David-Estevez/hebi/README.md

hebi
====

Electronics board for modular robots
