David-Estevez/hebi/KiCAD/bom.ods

Sheet: Old
ref | value | component info | manufacturer ref | price | footprint
C1 | 100nF | Ceramic, 0603 | VJ0603Y104KXJCW1BC |  | 0603
C2 | 24pF | Ceramic, 0603 | - |  | 0603
C3 | 24pF | Ceramic, 0603 | - |  | 0603
C4 | 10nF | Ceramic, 0603 | - |  | 0603
C5 | 4.7uF | Ceramic, LSR, 0805 | VJ0805V475ZXQTW1BC |  | 0805
C6 | 1uF | Tantalum, 1206 | - |  | 1206
C7 | 1uF | Tantalum, 1206 | - |  | 1206
C8 | 100nF | Ceramic, 0603 | VJ0603Y104KXJCW1BC |  | 0603
C9 | 100nF | Ceramic, 0603 | VJ0603Y104KXJCW1BC |  | 0603
C10 | 4.7uF X7R 0805 | X7R cap, 0805 | C2012X7R1A475M125AC |  | 0805
C11 | 220nF | Ceramic, LSR, 0603 | CC0603KRX7R7BB224 |  | 0603
C12 | 1uF X7R 0805 | X7R cap, 0805 | VJ0805Y105KXQTW1BC |  | 0805
C13 | 100nF | Ceramic, 0603 | VJ0603Y104KXJCW1BC |  | 0603
C14 | 100nF | Ceramic, 0603 | VJ0603Y104KXJCW1BC |  | 0603
C15 | 2.2uF | Tantalum ESR < 2, 1411 | T491B225K016AT |  | 1411
C16 | 100nF | Ceramic, 0603 | VJ0603Y104KXJCW1BC |  | 0603
C17 | 100nF | Ceramic, 0603 | VJ0603Y104KXJCW1BC |  | 0603
C18 | 2.2uF | Tantalum ESR < 2, 1411 | T491B225K016AT |  | 1411
C19 | 100nF | Ceramic, 0603 | VJ0603Y104KXJCW1BC |  | 0603
C20 | 100nF | Ceramic, 0603 | VJ0603Y104KXJCW1BC |  | 0603
C21 | 100nF | Ceramic, 0603 | VJ0603Y104KXJCW1BC |  | 0603
C22 | 22uF | Electrolytic, 5x5.3x5.3 | AVE226M10C12T-F |  | Custom (done)
C23 | 100nF | Ceramic, 0603 | VJ0603Y104KXJCW1BC |  | 0603
C24 | 100nF | Ceramic, 0603 | VJ0603Y104KXJCW1BC |  | 0603
C25 | 1uF | Ceramic, 0603 | VJ0603V105MXQPW1BC |  | 0603
C26 | 1uF | Ceramic, 0603 | VJ0603V105MXQPW1BC |  | 0603
CR1 | CG0603MLC-05LE | ESD Suppressor | 652-CG0603MLC-05LE | 0,32 € | 0603
CR2 | CG0603MLC-05LE | ESD Suppressor | 652-CG0603MLC-05LE | 0,32 € | 0603
D1 | GREEN | Green LED, 0603 | - |  | Mod footprint
D2 | ORANGE | Orange LED, 0603 | - |  | Mod footprint
D3 | RED | Red LED, 0603 | - |  | Mod footprint
D4 | BLUE | Blue LED, 0603 | - |  | Mod footprint
D5 | D_SCHOTTKY | 1A, 0.52V, DO-214AC (SMA) | B120-E3/5AT | 0,08 € | Custom (done)
D6 | D_SCHOTTKY | 1A, 0.52V, DO-214AC (SMA) | B120-E3/5AT | 0,08 € | Custom (done)
F1 | MF-MSMF050-2 | Resettable fuse | MF-MSMF050-2 | 0,17 € | Custom (done)
JP1 | JP_5 | SWD debug connector | B5B-ZR-SM4-TF |  | Custom (done)
JP2 | JUMPER-2 | Solder Jumper | Solder Jumper | 0 | 0402
JP3 | JUMPER-2 | Solder Jumper | Solder Jumper | 0 | 0402
JP4 | JUMPER-2 | Solder Jumper | Solder Jumper | 0 | 0402
JP5 | JUMPER-2 | Solder Jumper | Solder Jumper | 0 | 0402
K1 | CONN_3 | ADC connector | B3B-ZR-SM4-TF |  | Custom (done)
K2 | CONN_3 | Power connector | S3B-ZR-SM4A-TF |  | Custom (done)
K3 | CONN_3 | Servo Connector | B3B-ZR-SM4-TF |  | Custom (done)
K4 | CONN_3 | Servo Connector | B3B-ZR-SM4-TF |  | Custom (done)
K5 | CONN_3 | Servo Connector | B3B-ZR-SM4-TF |  | Custom (done)
L1 | fcm 0603 | Ferrite cheap beads | - |  | 0603
P1 | CONN_4 | Serial Connector | S4B-ZR-SM4A-TF |  | Custom (done)
P2 | CONN_4 | Serial Connector | S4B-ZR-SM4A-TF |  | Custom (done)
P3 | CONN_4 | Serial Connector | S4B-ZR-SM4A-TF |  | Custom (done)
P4 | CONN_4 | Serial Connector | S4B-ZR-SM4A-TF |  | Custom (done)
P5 | CONN_2 | Dynamixel Connector | B2B-ZR-SM4-TF |  | Custom (done)
P6 | CONN_2 | I2C Power Connector | S2B-ZR-SM4A-TF |  | Custom (done)
Q2 | MOS_N_DIODE | SOT-23 | BSS138BK,215 | 0,04 € | Check existent
Q3 | MOS_N_DIODE | SOT-23 | BSS138BK,215 | 0,04 € | Check existent
Q4 | MOS_N_DIODE | SOT-23 | BSS138BK,215 | 0,04 € | Check existent
Q5 | MOS_N_DIODE | SOT-23 | BSS138BK,215 | 0,04 € | Check existent
Q6 | MOS_N_DIODE | SOT-23 | BSS138BK,215 | 0,04 € | Check existent
Q7 | MOS_N_DIODE | SOT-23 | BSS138BK,215 | 0,04 € | Check existent
Q8 | MOS_N_DIODE | SOT-23 | BSS138BK,215 | 0,04 € | Check existent
Q9 | MOS_N | SOT-23 | ?¿ |  | SOT-23
Q10 | MOS_N_DIODE | SOT-23 | BSS138BK,215 | 0,04 € | Check existent
Q11 | MOS_N_DIODE | SOT-23 | BSS138BK,215 | 0,04 € | Check existent
R1 | 4.7K | Resistor, 0603 | - |  | 0603
R2 | 100K | Resistor, 0603 | - |  | 0603
R3 | 4.7K | Resistor, 0603 | - |  | 0603
R4 | 220K | Resistor, 0603 | - |  | 0603
R5 | 47R | Resistor, 0603 | - |  | 0603
R6 | 510R | Resistor, 0603 | - |  | 0603
R7 | 680R | Resistor, 0603 | - |  | 0603
R8 | 680R | Resistor, 0603 | - |  | 0603
R9 | 680R | Resistor, 0603 | - |  | 0603
R10 | 510R | Resistor, 0603 | - |  | 0603
R11 | 510R | Resistor, 0603 | - |  | 0603
R12 | 22R | Resistor, 0603 | - |  | 0603
R13 | 22R | Resistor, 0603 | - |  | 0603
R14 | 4.7K | Resistor, 0603 | - |  | 0603
R16 | 10K | Resistor, 0603 | - |  | 0603
R17 | 10K | Resistor, 0603 | - |  | 0603
R18 | 10K | Resistor, 0603 | - |  | 0603
R19 | 10K | Resistor, 0603 | - |  | 0603
R20 | 10K | Resistor, 0603 | - |  | 0603
R21 | 10K | Resistor, 0603 | - |  | 0603
R22 | 10K | Resistor, 0603 | - |  | 0603
R23 | 10K | Resistor, 0603 | - |  | 0603
R24 | 10K | Resistor, 0603 | - |  | 0603
R25 | 10K | Resistor, 0603 | - |  | 0603
R26 | 10K | Resistor, 0603 | - |  | 0603
R27 | 10K | Resistor, 0603 | - |  | 0603
R28 | 10K | Resistor, 0603 | - |  | 0603
R29 | 10K | Resistor, 0603 | - |  | 0603
R30 | 10K | Resistor, 0603 | - |  | 0603
R31 | 4.7K | Resistor, 0603 | - |  | 0603
R32 | 10K | Resistor, 0603 | - |  | 0603
R33 | 10K | Resistor, 0603 | - |  | 0603
R34 | 10K | Resistor, 0603 | - |  | 0603
R35 | 10K | Resistor, 0603 | - |  | 0603
R36 | 4.7K | Resistor, 0603 | #VALUE! |  | 0603
R37 | 4.7K | Resistor, 0603 | - |  | 0603
SW1 | SW_PUSH | Tactile Switches 3.5X6 SPDT | 506-FSMSM | 0,23 € | Custom (done)
SW2 | SW_PUSH | Tactile Switches 3.5X6 SPDT | 506-FSMSM | 0,23 € | Custom (done)
SW3 | SW_PUSH | Tactile Switches 3.5X6 SPDT | 506-FSMSM | 0,23 € | Custom (done)
U1 | L3GD20 | Gyro, LGA-16 | - | 5,41 € | Custom (done)
U2 | LSM303DLHC | Acc, LGA-14 (L) | - |  | No Footprint
U3 | MCP1825S | LDO 3V, SOT-223 | MCP1825S-3002E/DB | 0,45 € | Footprint
U4 | STM32F407VG | TQFP100 | - | 12,79 € | Don't know
U5 | XBEE | xBee SMD pin strips | DigiKey: S5902-10-ND |  | Custom (done)
U6 | 74AHC2G126 | Buffers, VSSOP8 | 74AHC2G126DC,125 | 0,17 € | Footprint
USB1 | USBCONN | USB mini type B | Ask for it |  | Footprint
X1 | 8MHz | 8MHz, 30ppm, 18pF | 7A-8.000MAAJ-T | 0,60 € | Custom (done)
 | Total price: | 21,44 € | 25,94 €
 |  | Worst case ( 1 board ) | VAT included

Sheet: Current
ref | value | component info | manufacturer ref | price | Vendor
C5 | 100nF | Ceramic, 0603 | VJ0603Y104KXJCW1BC | 0,05 € | Mouser
C6 | 24pF | Ceramic, 0603 | 06035A240JAT2A | 0,08 € | Mouser
C7 | 24pF | Ceramic, 0603 | 06035A240JAT2A | 0,08 € | Mouser
C9 | 1uF | Tantalum, 1206 | F931C105KAA | 0,11 € | Mouser
C10 | 1uF | Tantalum, 1206 | F931C105KAA | 0,11 € | Mouser
C11 | 100nF | Ceramic, 0603 | VJ0603Y104KXJCW1BC | 0,05 € | Mouser
C12 | 100nF | Ceramic, 0603 | VJ0603Y104KXJCW1BC | 0,05 € | Mouser
C13 | 4.7uF X7R 0805 | X7R cap, 0805 | C2012X7R1A475M125AC | 0,18 € | Mouser
C15 | 1uF X7R 0805 | X7R cap, 0805 | VJ0805Y105KXQTW1BC | 0,04 € | Mouser
C16 | 100nF | Ceramic, 0603 | VJ0603Y104KXJCW1BC | 0,05 € | Mouser
C17 | 100nF | Ceramic, 0603 | VJ0603Y104KXJCW1BC | 0,05 € | Mouser
C18 | 2.2uF | Tantalum ESR < 2, 1411 | T491B225K016AT | 0,40 € | Mouser
C19 | 100nF | Ceramic, 0603 | VJ0603Y104KXJCW1BC | 0,05 € | Mouser
C20 | 100nF | Ceramic, 0603 | VJ0603Y104KXJCW1BC | 0,05 € | Mouser
C21 | 2.2uF | Tantalum ESR < 2, 1411 | T491B225K016AT | 0,40 € | Mouser
C22 | 100nF | Ceramic, 0603 | VJ0603Y104KXJCW1BC | 0,05 € | Mouser
C23 | 100nF | Ceramic, 0603 | VJ0603Y104KXJCW1BC | 0,05 € | Mouser
C24 | 100nF | Ceramic, 0603 | VJ0603Y104KXJCW1BC | 0,05 € | Mouser
C25 | 22uF | Tantalum, 1411 | TM3B226K016CBA | 0,68 € | Mouser
C26 | 100nF | Ceramic, 0603 | VJ0603Y104KXJCW1BC | 0,05 € | Mouser
C27 | 100nF | Ceramic, 0603 | VJ0603Y104KXJCW1BC | 0,05 € | Mouser
C28 | 1uF | Ceramic, 0603 | VJ0603V105MXQPW1BC | 0,05 € | Mouser
C29 | 1uF | Ceramic, 0603 | VJ0603V105MXQPW1BC | 0,05 € | Mouser
CR1 | CG0603MLC-05LE | ESD Suppressor | 652-CG0603MLC-05LE | 0,32 € | Mouser
CR2 | CG0603MLC-05LE | ESD Suppressor | 652-CG0603MLC-05LE | 0,32 € | Mouser
D1 | GREEN | Green LED, 0603 | LTST-C193TBKT-5A | 0,08 € | Mouser
D2 | ORANGE | Orange LED, 0603 | VLMO1300-GS08 | 0,06 € | Mouser
D3 | RED | Red LED, 0603 | VLMS1300-GS08 | 0,06 € | Mouser
D4 | BLUE | Blue LED, 0603 | LG Q971-KN-1 | 0,04 € | Mouser
D5 | D_SCHOTTKY | 1A, 0.52V, DO-214AC (SMA) | B120-E3/5AT | 0,08 € | Mouser
D6 | D_SCHOTTKY | 1A, 0.52V, DO-214AC (SMA) | B120-E3/5AT | 0,08 € | Mouser
F1 | MF-MSMF050-2 | Resettable fuse | MF-MSMF050-2 | 0,17 € | Mouser
JP2 | JP_5 | SWD debug connector | B5B-ZR-SM4-TF | 0,75 € | Digikey | x
JP3 | JUMPER-2 | Solder Jumper | Solder Jumper | 0
JP4 | JUMPER-2 | Solder Jumper | Solder Jumper | 0
JP5 | JUMPER-2 | Solder Jumper | Solder Jumper | 0
JP6 | JUMPER-2 | Solder Jumper | Solder Jumper | 0
K1 | CONN_3 | ADC connector | B3B-ZR-SM4-TF | 0,63 € | Digikey | x
K2 | CONN_3 | Power connector | S3B-ZR-SM4A-TF | 0,68 € | Digikey | x
K3 | CONN_3 | Servo Connector | B3B-ZR-SM4-TF | 0,63 € | Digikey | x
K4 | CONN_3 | Servo Connector | B3B-ZR-SM4-TF | 0,63 € | Digikey | x
K5 | CONN_3 | Servo Connector | B3B-ZR-SM4-TF | 0,63 € | Digikey | x
L1 | fcm 0603 | Ferrite cheap beads | 2506036007Y3 | 0,02 € | Mouser
P1 | CONN_4 | Serial Connector | S4B-ZR-SM4A-TF | 0,68 € | Digikey | x
P2 | CONN_4 | Serial Connector | S4B-ZR-SM4A-TF | 0,68 € | Digikey | x
P3 | CONN_4 | Serial Connector | S4B-ZR-SM4A-TF | 0,68 € | Digikey | x
P4 | CONN_4 | Serial Connector | S4B-ZR-SM4A-TF | 0,68 € | Digikey | x
P6 | CONN_2 | I2C Power Connector | S2B-ZR-SM4A-TF | 0,54 € | Digikey | x
Q1 | MOS_N_DIODE | SOT-23 | BSS138BK,215 | 0,04 € | Mouser
Q2 | MOS_N_DIODE | SOT-23 | BSS138BK,215 | 0,04 € | Mouser
Q3 | MOS_N_DIODE | SOT-23 | BSS138BK,215 | 0,04 € | Mouser
Q4 | MOS_N_DIODE | SOT-23 | BSS138BK,215 | 0,04 € | Mouser
Q5 | MOS_N_DIODE | SOT-23 | BSS138BK,215 | 0,04 € | Mouser
Q6 | MOS_N_DIODE | SOT-23 | BSS138BK,215 | 0,04 € | Mouser
Q7 | MOS_N_DIODE | SOT-23 | BSS138BK,215 | 0,04 € | Mouser
Q9 | MOS_N_DIODE | SOT-23 | BSS138BK,215 | 0,04 € | Mouser
Q10 | MOS_N_DIODE | SOT-23 | BSS138BK,215 | 0,04 € | Mouser
R1 | 100K | Resistor, 0603 | CRCW0603100KFKEA | 0,06 € | Mouser
R2 | 220K | Resistor, 0603 | RK73B1JTTD224J | 0,06 € | Mouser
R3 | 47 | Resistor, 0603 | CRCW060347R0JNEA | 0,06 € | Mouser
R5 | 510 | Resistor, 0603 | RK73H1JTTD5100F | 0,06 € | Mouser
R6 | 680 | Resistor, 0603 | CRCW0603680RFKEA | 0,06 € | Mouser
R7 | 680 | Resistor, 0603 | CRCW0603680RFKEA | 0,06 € | Mouser
R8 | 680 | Resistor, 0603 | CRCW0603680RFKEA | 0,06 € | Mouser
R10 | 510 | Resistor, 0603 | RK73H1JTTD5100F | 0,06 € | Mouser
R11 | 510 | Resistor, 0603 | RK73H1JTTD5100F | 0,06 € | Mouser
R12 | 22R | Resistor, 0603 | CRCW060322R0FKEA | 0,06 € | Mouser
R13 | 22R | Resistor, 0603 | CRCW060322R0FKEA | 0,06 € | Mouser
R14 | 4.7K | Resistor, 0603 | RK73H1JTTD4701F | 0,06 € | Mouser
R15 | 10K | Resistor, 0603 | AF0603FR-0710KL | 0,02 € | Mouser
R16 | 10K | Resistor, 0603 | AF0603FR-0710KL | 0,02 € | Mouser
R17 | 10K | Resistor, 0603 | AF0603FR-0710KL | 0,02 € | Mouser
R18 | 10K | Resistor, 0603 | AF0603FR-0710KL | 0,02 € | Mouser
R19 | 10K | Resistor, 0603 | AF0603FR-0710KL | 0,02 € | Mouser
R20 | 10K | Resistor, 0603 | AF0603FR-0710KL | 0,02 € | Mouser
R21 | 10K | Resistor, 0603 | AF0603FR-0710KL | 0,02 € | Mouser
R22 | 10K | Resistor, 0603 | AF0603FR-0710KL | 0,02 € | Mouser
R23 | 10K | Resistor, 0603 | AF0603FR-0710KL | 0,02 € | Mouser
R24 | 10K | Resistor, 0603 | AF0603FR-0710KL | 0,02 € | Mouser
R25 | 10K | Resistor, 0603 | AF0603FR-0710KL | 0,02 € | Mouser
R26 | 10K | Resistor, 0603 | AF0603FR-0710KL | 0,02 € | Mouser
R27 | 10K | Resistor, 0603 | AF0603FR-0710KL | 0,02 € | Mouser
R28 | 10K | Resistor, 0603 | AF0603FR-0710KL | 0,02 € | Mouser
R31 | 10K | Resistor, 0603 | AF0603FR-0710KL | 0,02 € | Mouser
R32 | 10K | Resistor, 0603 | AF0603FR-0710KL | 0,02 € | Mouser
R33 | 10K | Resistor, 0603 | AF0603FR-0710KL | 0,02 € | Mouser
R34 | 10K | Resistor, 0603 | AF0603FR-0710KL | 0,02 € | Mouser
SW1 | SW_PUSH | Tactile Switches 3.5X6 SPDT | 506-FSMSM | 0,23 € | Mouser
SW2 | SW_PUSH | Tactile Switches 3.5X6 SPDT | 506-FSMSM | 0,23 € | Mouser
SW3 | SW_PUSH | Tactile Switches 3.5X6 SPDT | 506-FSMSM | 0,23 € | Mouser
U3 | MCP1825S | LDO 3V, SOT-223 | MCP1825S-3002E/DB | 0,45 € | Mouser
U4 | STM32F407VG | TQFP100 | STM32F407VGT6 | 12,79 € | Mouser | x
U5 | XBEE | xBee SMD pin strips | DigiKey: S5902-10-ND | 2,96 € | Digikey | x
USB1 | USBCONN | USB micro type B | 649-10118192-0001LF | 1,00 € | Mouser
X1 | 8MHz | 8MHz, 30ppm, 18pF | 7A-8.000MAAJ-T | 0,60 € | Mouser
 |  |  | Total: | 31,12 € | Each board
 |  |  | PCBs | 28,94 €
 |  |  | Total: | 60,06 €
