David-Estevez/hebi/(list of files, drawings)

Other design files:
hebi.fzz
