David-Estevez/hebi/KiCAD/hebi.kicad_pcb

## KiCad design KiCAD/hebi.kicad_pcb (2014-09-03)

Schematic: hebi.sch, HEBI - Electronic Board for Modular Robots (STM32F4 flavour)

Parts:
C5, C11, C12, C16, C17, C19, C20, C22, C23, C24, C26, C27: 100nF
C6, C7: 24pF
C9, C10, C28, C29: 1uF
C13: 4.7uF X7R 0805
C15: 1uF X7R 0805
C18, C21: 2.2uF
C25: 22uF
CR1, CR2: CG0603MLC-05LE
D1: GREEN
D2: ORANGE
D3: RED
D4: BLUE
D5, D6: D_SCHOTTKY
F1: MF-MSMF050-2
JP2: JP_5
JP3, JP4, JP5, JP6: JUMPER-2
K1, K2, K3, K4, K5: CONN_3
L1: fcm 0603
P1, P2, P3, P4: CONN_4
P6: CONN_2
Q1, Q2, Q3, Q4, Q5, Q6, Q7, Q9, Q10: MOS_N_DIODE
R1: 100K
R2: 220K
R3: 47
R5, R10, R11: 510
R6, R7, R8: 680
R12, R13: 22R
R14: 4.7K
R15, R16, R17, R18, R19, R20, R21, R22, R23, R24, R25, R26, R27, R28, R31, R32, R33, R34: 10K
SW1, SW2, SW3: SW_PUSH
U3: MCP1825S
U4: STM32F407VG; TQFP100
U5: XBEE
USB1: USBCONN
X1: 8MHz

Connections:
+5V: C13.1, D5.1, D6.1, R20.1, R21.1, R22.1, R23.1, R24.1, R27.1, R28.1, R33.1, R34.1, U3.1 (Vin)
/ADC1: K1.1, U4.15 (PC0/OTG_HS_ULPI_STP/EVENTOUT)
/ADC2: K1.2 (PM), U4.16 (PC1/ETH_MDC/_EVENTOUT)
/ADC3: K1.3, U4.33 (PC4/ETH_RMII_RX_D0/ETH_MII_RX_D0/EVENTO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)
/BOOT0: R11.1, SW3.2, U4.94 (BOOT0)
/BOOT1: R10.1, U4.37 (PB2/BOOT1/EVENTOUT)
/D+: R12.1, U4.71 (PA12/USART1_RTS/CAN1_TX/TIM1_ETR/OTG_FS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)
/D-: R13.1, U4.70 (PA11/USART1_CTS/CAN1_RX/TIM1_CH4_/OTG_F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)
/I2C_SCL_PWR_3V: Q2.S, R16.2, U4.67 (PA8/MCO1/USART1_CK/TIM1_CH1/I2C3_SCL/OT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)
/I2C_SCL_PWR_5V: P6.2 (PM), Q2.D, R21.2
/I2C_SDA_PWR_3V: Q1.S, R15.2, U4.66 (PC9/I2S_CKIN/MCO2/TIM8_CH4/SDIO_D1/I2C3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)
/I2C_SDA_PWR_5V: P6.1, Q1.D, R20.2
/LED1: D1.1 (A), U4.4 (PE5/TRACED2/FSMC_A21/TIM9_CH1/DCMI_D6/E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)
/LED2: D2.1 (A), U4.95 (PB8/TIM4_CH3/SDIO_D4/TIM10_CH1/DCMI_D6/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)
/LED3: D3.1 (A), U4.96 (PB9/SPI2_NSS/I2S2_WS/TIM4_CH4/TIM11_CH1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)
/LED4: D4.1 (A), U4.53 (PB14/SPI2_MISO/TIM1_CH2N/TIM12_CH1/OTG_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)
/PUSH_SW: R2.1, SW2.2, U4.59 (PD12/FSMC_ALE/FSMC_A17/TIM4_CH1/USART3_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)
/RESET: C5.1, JP2.4, R1.2, SW1.1, U4.14 (NRST)
/RX1: P1.2, U4.87 (PD6/FSMC_NWAIT/USART2_RX/EVENTOUT)
/RX2: P3.2, U4.64 (PC7/I2S3_MCK/TIM8_CH2/SDIO_D7/USART6_RX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)
/RX3: P2.2, U4.56 (PD9/FSMC_D14/USART3_RX/EVENTOUT)
/RX4: P4.2, U4.93 (PB7/I2C1_SDA/FSMC_NL/DCMI_VSYNC/USART1_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)
/SERVO1_3V: Q3.S, R17.2, U4.40 (PE9/FSMC_D6/TIM1_CH1/EVENTOUT)
/SERVO1_5V: K3.3, Q3.D, R22.2
/SERVO2_3V: Q4.S, R18.2, U4.65 (PC8/TIM8_CH3/SDIO_D0/TIM3_CH3/USART6_CK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)
/SERVO2_5V: K4.3, Q4.D, R23.2
/SERVO3_3V: Q5.S, R19.2, U4.35 (PB0/TIM3_CH3/TIM8_CH2N/OTG_HS_ULPI_D1/E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)
/SERVO3_5V: K5.3, Q5.D, R24.2
/SERVO_PWR: C29.1, K2.2 (PM), K3.2 (PM), K4.2 (PM), K5.2 (PM)
/SPI1_MISO: U4.31 (PA6/SPI1_MISO/TIM8_BKIN/TIM13_CH1/DCMI_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)
/SPI1_MOSI: U4.32 (PA7/SPI1_MOSI/TIM8_CH1N/TIM14_CH1/TIM3_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)
/SPI1_NSS: U4.29 (PA4/SPI1_NSS/SPI3_NSS/USART2_CK/DCMI_HS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)
/SPI1_SCK: U4.30 (PA5/SPI1_SCK/OTG_HS_ULPI_CK/TIM2_CH1_ET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)
/SWCLK: JP2.3, U4.76 (PA14/JTCK/SWCLK/EVENTOUT)
/SWDIO: JP2.2, U4.72 (PA13/JTMS/SWDIO/EVENTOUT)
/TX1: JP3.2, P1.3, Q6.D, R27.2
/TX1_3V: JP3.1, Q6.S, R25.2, U4.86 (PD5/FSMC_NWE/USART2_TX/EVENTOUT)
/TX2: JP5.2, P3.3, Q9.D, R33.2
/TX2_3V: JP5.1, Q9.S, R31.2, U4.63 (PC6/I2S2_MCK/TIM8_CH1/SDIO_D6/USART6_TX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)
/TX3: JP4.2, P2.3, Q7.D, R28.2
/TX3_3V: JP4.1, Q7.S, R26.2, U4.55 (PD8/FSMC_D13/USART3_TX/EVENTOUT)
/TX4: JP6.2, P4.3, Q10.D, R34.2
/TX4_3V: JP6.1, Q10.S, R32.2, U4.92 (PB6/I2C1_SCL/TIM4_CH1/CAN2_TX/DCMI_D5/U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)
/T_SWO: U4.89 (PB3/JTDO/TRACESWO/SPI3_SCK/I2S3_CK/TIM2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)
/VBUS: C25.1, F1.1 (A), USB1.1 (VBUS)
/VIN: D5.2, K2.1
/VUSB: C22.1, D6.2, F1.2 (B)
/XBEE_RESET: R14.2, U5.5 (RESET)
/XBEE_RX: U4.23 (PA0/WKUP/USART2_CTS/UART4_TX/ETH_MII_CR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), U5.3 (DIN)
/XBEE_SLEEP: U4.97 (PE0/TIM4_ETR/FSMC_NBL0/DCMI_D2/EVENTOUT), U5.9 (^DTR/DI8)
/XBEE_TX: U4.24 (PA1/USART2_RTS/UART4_RX/ETH_RMII_REF_CL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), U5.2 (DOUT)
GND: C5.2, C6.1, C7.1, C9.2, C10.2, C11.2, C12.2, C13.2, C15.2, C16.1, C17.1, C18.2, C19.1, C20.1, C21.2, C22.2, C23.1, C24.1, C25.2, C26.1, C27.1, C28.1, C29.2, CR1.2 (Anode), CR2.2 (Anode), JP2.5, K2.3, K3.1, K4.1, K5.1, P1.4, P2.4, P3.4, P4.4, R2.2, R5.2, R6.2, R7.2, R8.2, R10.2, R11.2, SW1.2, U3.2 (GND), U3.4 (GND), U4.10 (VSS), U4.20 (VSSA), U4.27 (VSS), U4.74 (VSS), U4.99 (VSS), U5.10 (GND), USB1.4 (GND), USB1.5 (SHIELD)
unnamed: C9.1, C11.1, L1.2, R3.1, U4.22 (VDDA)
unnamed: C10.1, C12.1, R3.2, U4.21 (VREF+)
unnamed: C21.1, U4.73 (VCAP_2)
unnamed: C18.1, U4.49 (VCAP_1)
unnamed: CR1.1 (cathode), R12.2, USB1.3 (DP)
unnamed: CR2.1 (cathode), R13.2, USB1.2 (DN)
unnamed: D4.2 (K), R8.1
unnamed: D3.2 (K), R7.1
unnamed: D2.2 (K), R6.1
unnamed: D1.2 (K), R5.1
unnamed: C6.2, U4.12 (PH0/OSC_IN/EVENTOUT), X1.1
unnamed: C7.2, U4.13 (PH1/OSC_OUT/EVENTOUT), X1.2
VCC: C15.1, C16.2, C17.2, C19.2, C20.2, C23.2, C24.2, C26.2, C27.2, C28.2, JP2.1, L1.1, P1.1, P2.1, P3.1, P4.1, Q1.G, Q2.G, Q3.G, Q4.G, Q5.G, Q6.G, Q7.G, Q9.G, Q10.G, R1.1, R14.1, R15.1, R16.1, R17.1, R18.1, R19.1, R25.1, R26.1, R31.1, R32.1, SW2.1, SW3.1, U3.3 (Vout), U4.6 (VBAT), U4.11 (VDD), U4.19 (VDD), U4.28 (VDD), U4.50 (VDD), U4.75 (VDD), U4.100 (VDD), U5.1 (VCC)

Notes on the sheet:
NOTE: VBAT is the RTC backup power supply, and must lie between 1.65V and 3.6V
Power supply filtering
USER button
RESET button
BOOT configuration (for enabling the bootloader)
Analog power supply
It might be useful to make VSSA to go to a analog ground plane
SWD (Serial wire debugging) connector
USB Port
or-ing power supplies circuit
LED indicators
SERVO headers
Serial ports to other modules
xBee connector
Connector for the power suppy module
LDO Power Regulator In: 5-6V Out: 3V
'0' > from flash '1' > DFU Mode
ADC connector
Power Flags
STM32F4 Microcontroller
Since this needs 9.6V to work I'm currently thinking of breaking out the 3 control pins ( Rx, Tx, Dir) to connect them to an expansion module.
DYNAMIXEL servo control

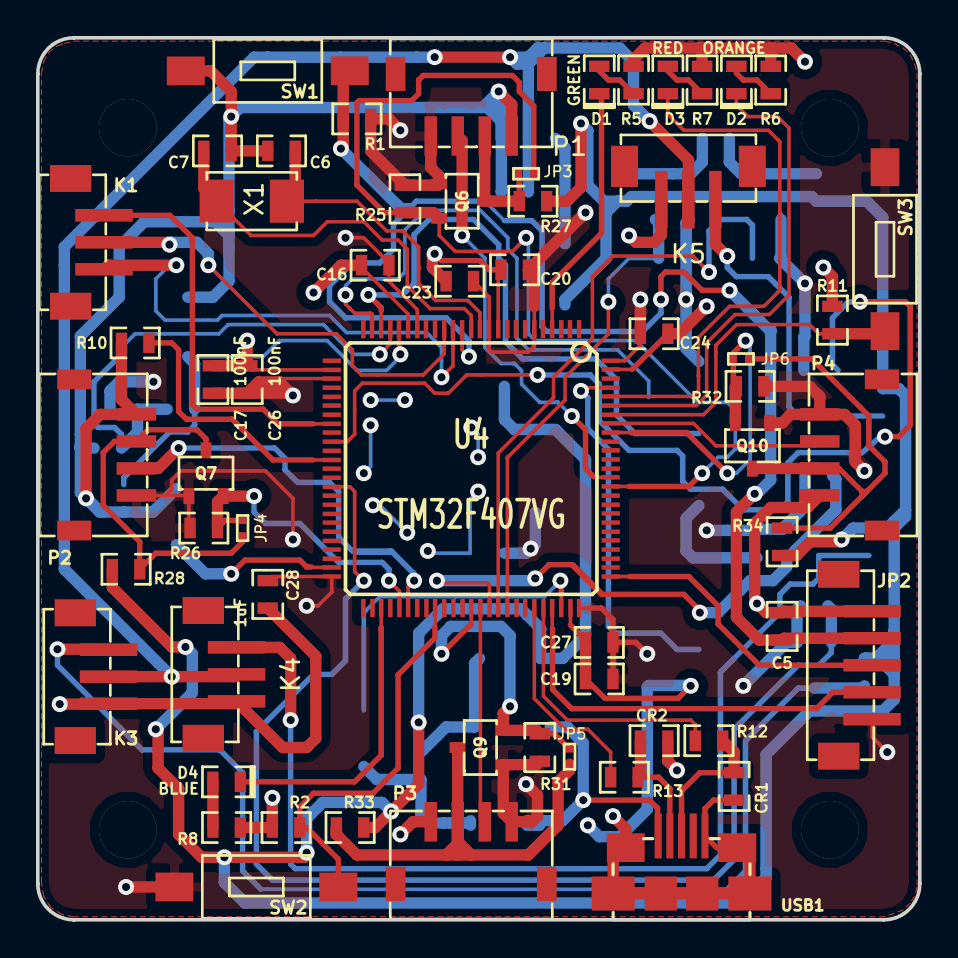
[picture p1: board hebi.kicad_pcb from above]

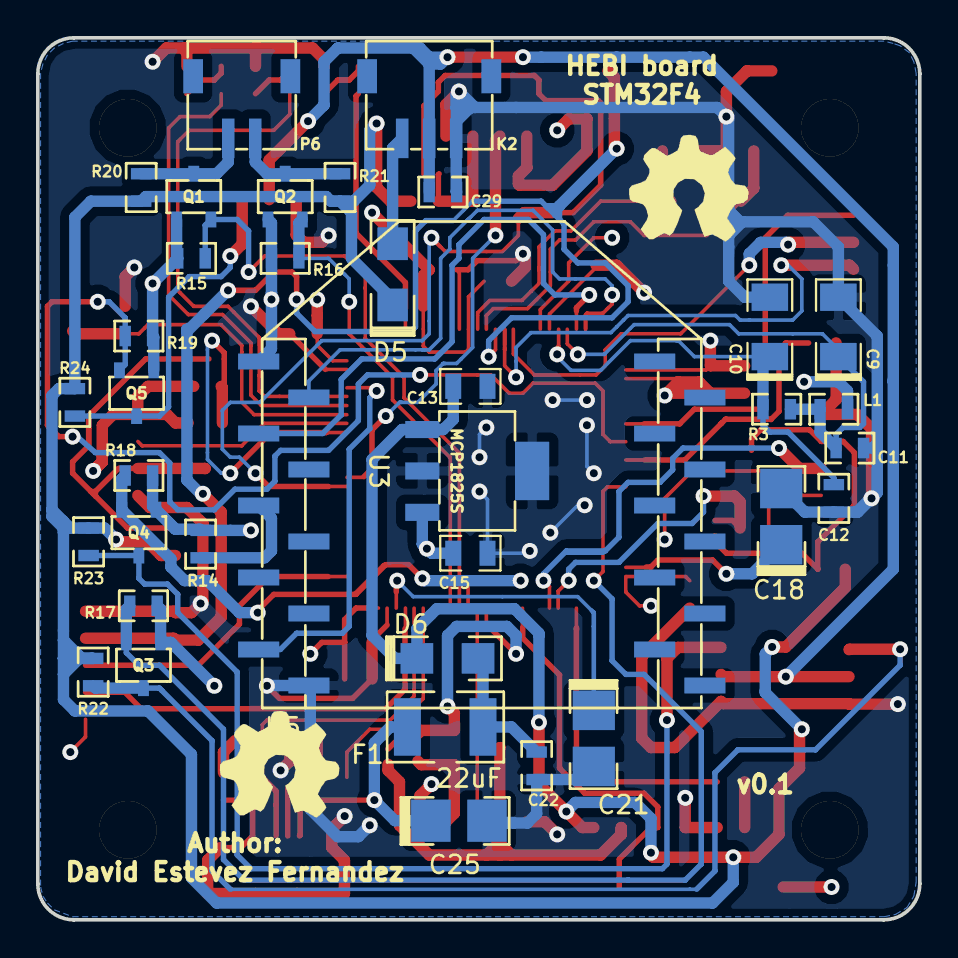
[picture p2: board hebi.kicad_pcb from below]

Board: 4 copper layers, 49.0 x 49.0 mm, 99 parts (36 on the bottom side), 60 nets.

Other parts of the board:
Taladro3mm, Taladro3mm#2, Taladro3mm#3, Taladro3mm#4: 3mm; Taladro3mm
