David-Estevez/hebi/(commit log)

2013-08-08 Basic design. Just basic circuitry for uC
    [hebi.sch]
2013-08-08 Added connectors for some peripherals.
    [hebi.sch]
2013-08-09 Perfboard prototype
    [hebi.fzz]
2013-08-09 Small changes.
    [hebi.fzz]
2013-08-15 Prototype design updated.
    [hebi.fzz]
2013-08-27 Added Arduino test01 for testing board.
2013-08-28 Schematic updated.
    [hebi.sch]
2013-08-29 Test 1 updated to test also servos
2014-01-15 Added MCU and basic circuits. Pin assignment.
    [STM32F4xx.sch, hebi.sch]
2014-01-16 Added Power supply filtering and usb port
    [STM32F4xx.sch, hebi.sch]
2014-01-17 Added serial ports and servo connectors.
    [STM32F4xx.sch, hebi.sch]
2014-01-21 Added buffers for serial ports, dynamixel connector.
    [STM32F4xx.sch, hebi.sch]
2014-01-22 Corrected xbee pinout, corrected serial buffers.
    [STM32F4xx.sch, hebi.sch]
2014-01-27 Added IMU.
    [STM32F4xx.sch, hebi.sch]
2014-01-27 Added power regulator.
    [STM32F4xx.sch, hebi.sch]
2014-01-28 Added component values.
    [STM32F4xx.sch, hebi.sch]
2014-01-30 Added ADC connector.
    [STM32F4xx.sch, hebi.sch]
2014-01-30 Finished most of the schematic (except power selection).
    [STM32F4xx.sch, hebi.sch]
2014-01-31 Added or-ing circuit
    [hebi.sch]
2014-01-31 ERC checked. Generated Netlist.
    [hebi.sch]
2014-02-07 Modified some schematic values.
    [hebi.sch]
2014-02-07 Added bom file.
    [bom.ods]
2014-02-10 Assigned some footprints to netlist.
    [bom.ods, hebi.sch]
2014-02-11 More footprints added.
    [bom.ods]
2014-02-13 Changed Opendous to Opendous Custom. Added Footprints for ZH connectors.
    [bom.ods]
2014-02-14 Added last two ZH connectors.
2014-02-17 Added XBee footprint.
    [bom.ods]
2014-02-18 Added new magnetic compass.
    [hebi.sch]
2014-02-19 Solved IMU issue on schematic, changed annotation.
    [bom.ods, hebi.sch]
2014-02-20 Created new footprints for the MPU-6050 and HMC58583L.
    [bom.ods]
2014-02-24 Added footprints.
    [bom.ods]
2014-02-24 Added regulator footprint.
    [bom.ods]
2014-02-24 Placed footprints on pcb view.
    [hebi.kicad_pcb]
2014-03-21 Placed some components on the PCB.
    [hebi.kicad_pcb, hebi.sch]
2014-03-24 Placed more footprints on board.
    [hebi.kicad_pcb]
2014-03-24 Removed dynamixel due to spatial requirements (no space left for that)
    [hebi.kicad_pcb, hebi.sch]
2014-03-25 Routed front layer (mostly, without vias)
    [hebi.kicad_pcb]
2014-03-27 Traced more traces.
    [hebi.kicad_pcb]
2014-03-28 Added even more tracks.
    [hebi.kicad_pcb, hebi.sch]
2014-04-01 Routed even more things.
    [hebi.kicad_pcb]
2014-04-02 Routed power tracks, removed IMU.
    [hebi.kicad_pcb, hebi.sch]
2014-04-09 Routed things, power planes added, rounded corners.
    [hebi.kicad_pcb]
2014-04-10 Fixed silkscreen (now it is nice)
    [hebi.kicad_pcb]
2014-04-21 Modified electrolytic capacitor to tantalum one.
    [bom.ods, hebi.kicad_pcb, hebi.sch]
2014-09-03 Minor fixes.
    [bom.ods, hebi.kicad_pcb]
